Cobalt-Walnut/Insole-Research-Paper/README.md

# Insole-Research-Paper
The repository for all source code and files used in the Insole Research Paper

[View PDF](main-5.pdf)

# Abstract:
