Cobalt-Walnut/Insole-Research-Paper/CAD_Files/Individual_Files/Insole V2 - Main.step

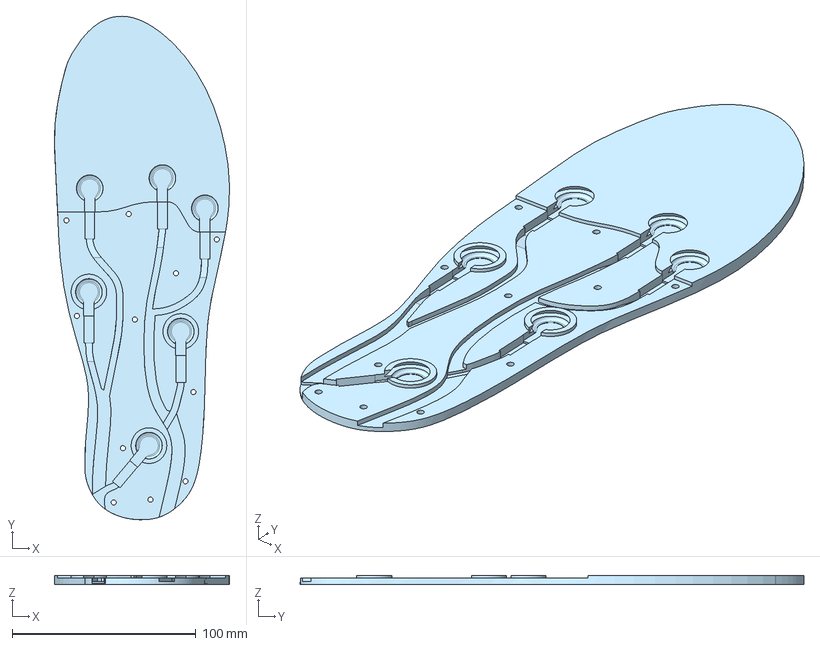
[picture p22: CAD file, 2026-08-30]
CAD_Files/Individual_Files/Insole V2 - Main.step
95.2 x 274.0 x 5.00 mm
