Cobalt-Walnut/Insole-Research-Paper/CAD_Files/Insole Full Assembly.step

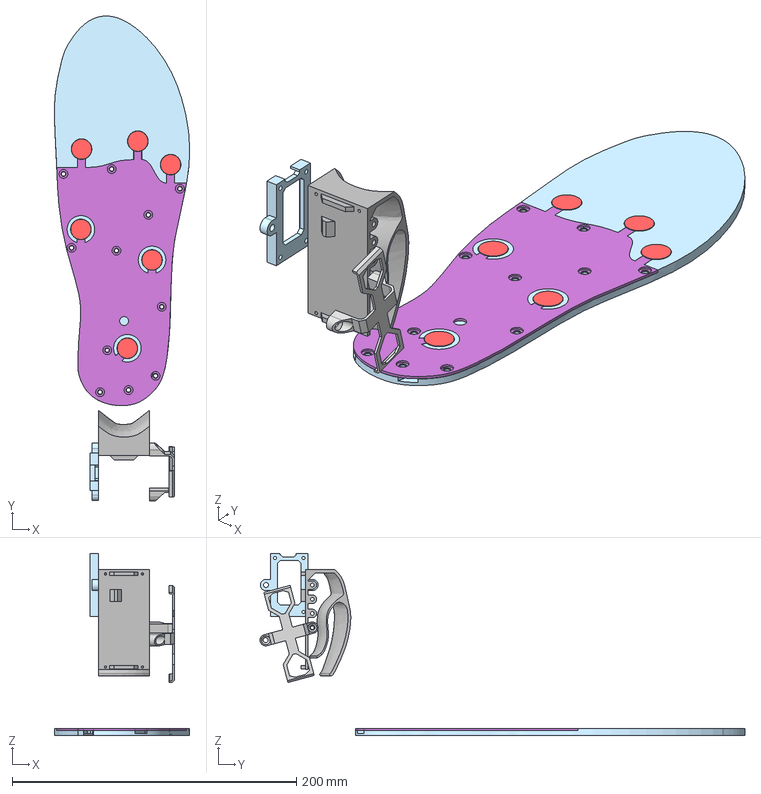
[picture p23: CAD file, 2026-08-30]
CAD_Files/Insole Full Assembly.step
95.3 x 341.1 x 128.3 mm
Insole-Contact_Puck x 6
Micro SD Card Module Mount
Electronics Mount
M3_34mm
Insole-Main
Insole-Cover
