Cobalt-Walnut/Insole-Research-Paper/CAD_Files/Individual_Files/Insole V2 - Part 6.step

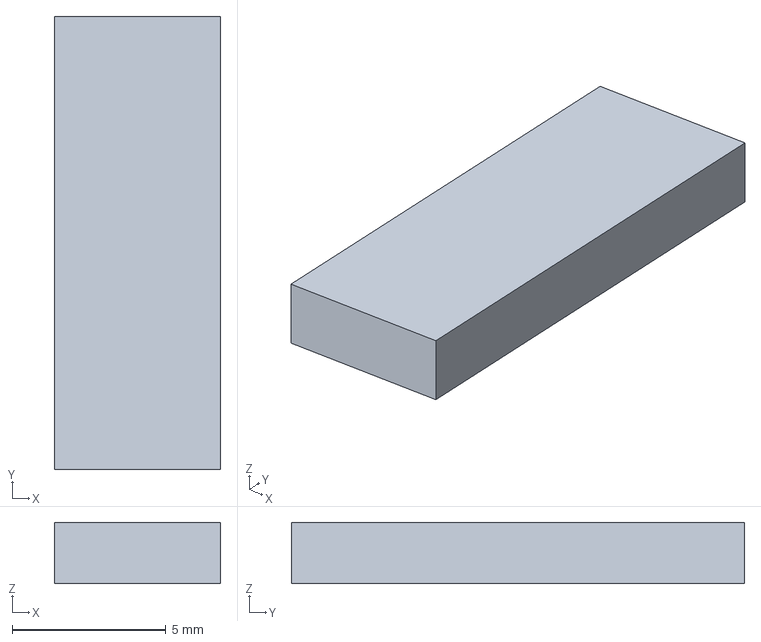
[picture p24: CAD file, 2026-08-30]
CAD_Files/Individual_Files/Insole V2 - Part 6.step
5.40 x 14.7 x 2.00 mm
