Cobalt-Walnut/Insole-Research-Paper/CAD_Files/Individual_Files/Insole V2 - Part 5.step

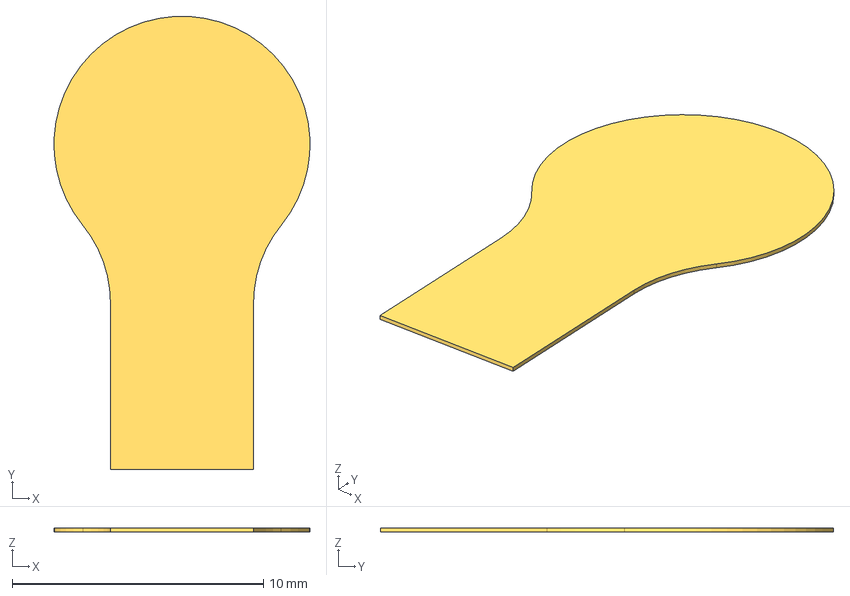
[picture p25: CAD file, 2026-08-30]
CAD_Files/Individual_Files/Insole V2 - Part 5.step
10.2 x 18.0 x 0.15 mm
