Cobalt-Walnut/Insole-Research-Paper/CAD_Files/Individual_Files/Insole V2 - Cover.step

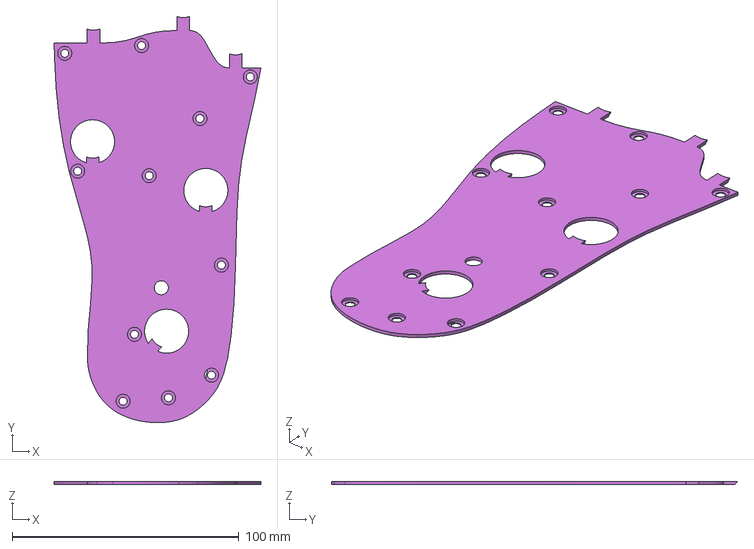
[picture p26: CAD file, 2026-08-30]
CAD_Files/Individual_Files/Insole V2 - Cover.step
91.3 x 179.3 x 1.25 mm
