Cobalt-Walnut/Insole-Research-Paper/CAD_Files/Individual_Files/Insole V2 - Contact Puck.step

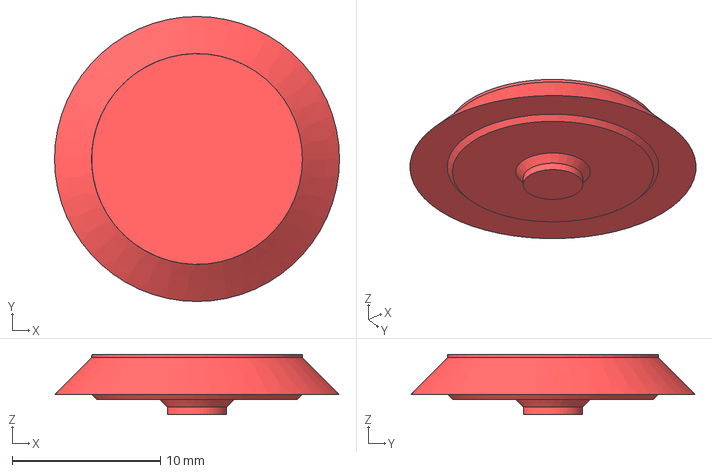
[picture p27: CAD file, 2026-08-30]
CAD_Files/Individual_Files/Insole V2 - Contact Puck.step
19.2 x 19.2 x 4.05 mm
